jusboa/coop_door/README.md

# coop_door
Chicken coop door

Opens/closes a chicken coop door based on the daylight. Door is operated by a DC motor. Daylight is detected via a photoresistor.

Software runs on Raspberry Pico. Powered by battery.
