jusboa/coop_door/hw/coop_door.kicad_pcb

## KiCad design hw/coop_door.kicad_pcb (2025-11-10)

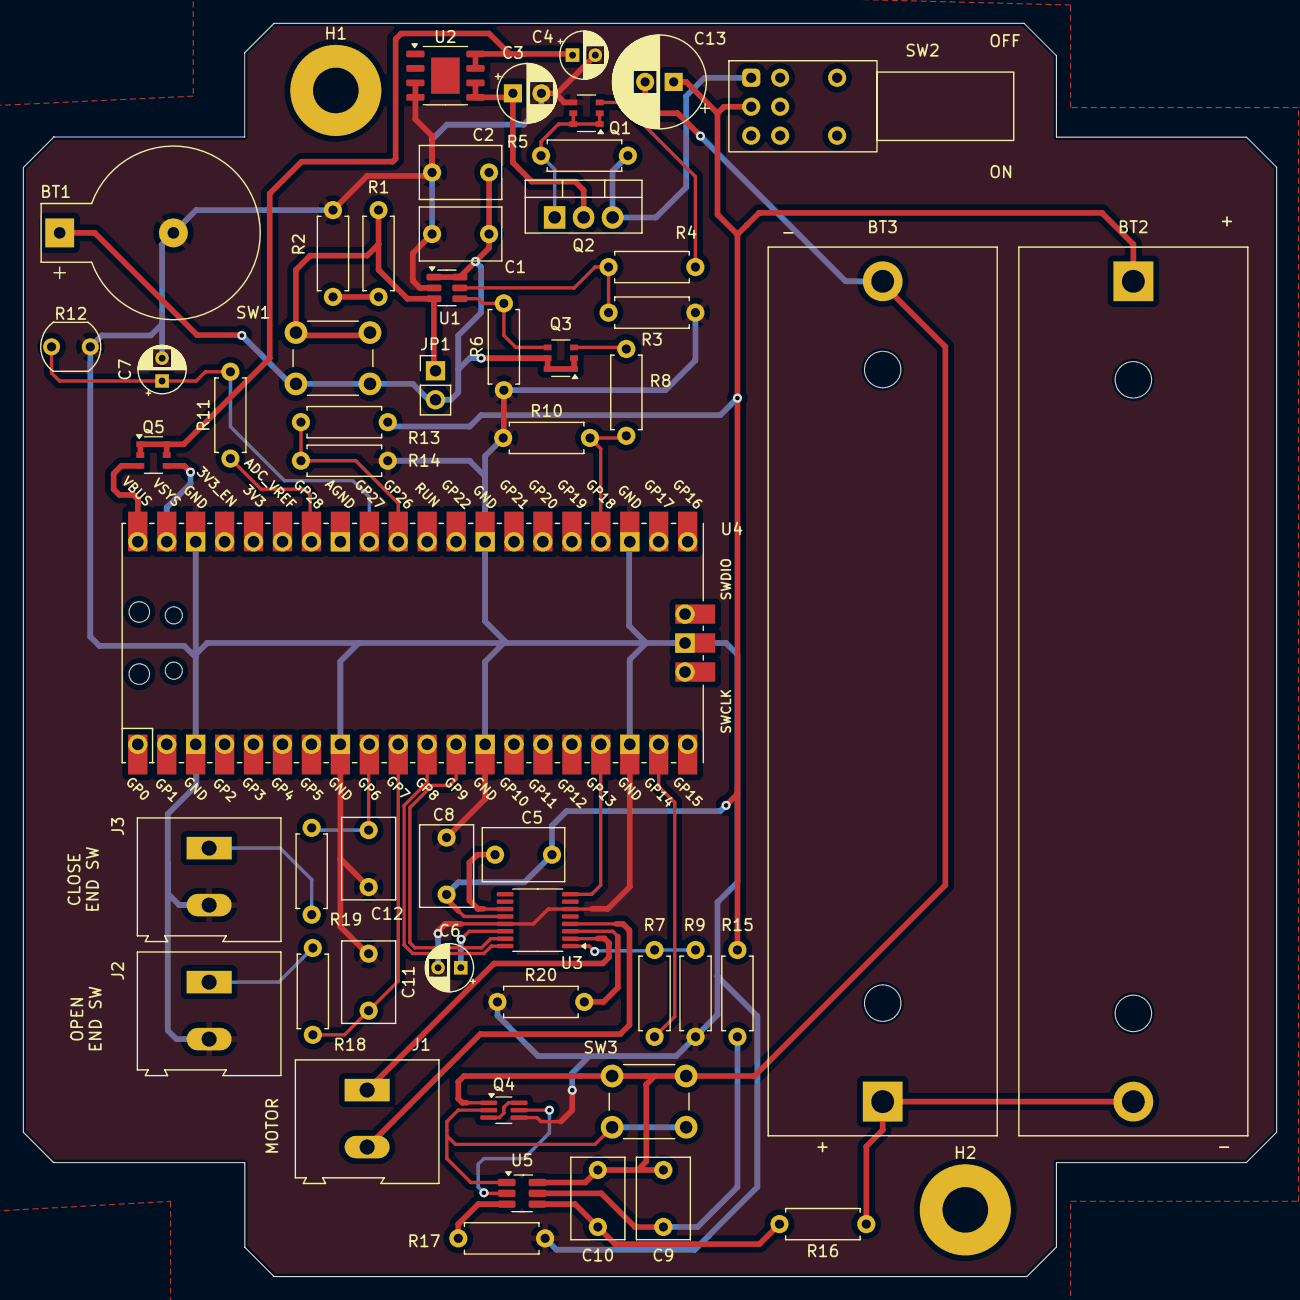
[picture p1: board coop_door.kicad_pcb from above]

Board: 2 copper layers, 110.0 x 110.0 mm, 55 parts (0 on the bottom side), 41 nets.

Parts:
BT1: CR1220; BatteryHolder_Keystone_500
BT2, BT3: Battery_Cell; BatteryHolder_MPD_BH-18650-PC2
C1, C9, C10: 0.1u; C_Rect_L7.0mm_W4.5mm_P5.00mm
C2, C8: 10u; C_Rect_L7.0mm_W4.5mm_P5.00mm
C3: 1u; CP_Radial_D5.0mm_P2.50mm
C4, C6: 2.2u; CP_Radial_D4.0mm_P2.00mm
C5: 10n; C_Rect_L7.0mm_W4.5mm_P5.00mm
C7: 4.7u; CP_Radial_D4.0mm_P2.00mm
C11, C12: 2.2u; C_Rect_L7.0mm_W4.5mm_P5.00mm
C13: 680u; CP_Radial_D8.0mm_P2.50mm
H1, H2: MountingHole; MountingHole_4mm_Pad
J1, J2, J3: Screw_Terminal_01x02; TerminalBlock_Altech_AK300-2_P5.00mm
JP1: Jumper_2_Open; PinHeader_1x02_P2.54mm_Vertical
Q1, Q3: IRLTS6342; TSOP-6_1.65x3.05mm_P0.95mm
Q2: IRF4905; TO-220-3_Vertical
Q4: BSD235NH; SOT-363_SC-70-6_Handsoldering
Q5: BSL207SPH; TSOP-6_1.65x3.05mm_P0.95mm
R1, R2: 47k; R_Axial_DIN0207_L6.3mm_D2.5mm_P7.62mm_Horizontal
R3, R6: 51k; R_Axial_DIN0207_L6.3mm_D2.5mm_P7.62mm_Horizontal
R4, R7, R8: 1k; R_Axial_DIN0207_L6.3mm_D2.5mm_P7.62mm_Horizontal
R5, R9, R10, R11: 10k; R_Axial_DIN0207_L6.3mm_D2.5mm_P7.62mm_Horizontal
R12: GL5516; R_LDR_5.1x4.3mm_P3.4mm_Vertical
R13: 15k; R_Axial_DIN0207_L6.3mm_D2.5mm_P7.62mm_Horizontal
R14, R18, R19: 5k; R_Axial_DIN0207_L6.3mm_D2.5mm_P7.62mm_Horizontal
R15, R16: 470; R_Axial_DIN0207_L6.3mm_D2.5mm_P7.62mm_Horizontal
R17: 2k; R_Axial_DIN0207_L6.3mm_D2.5mm_P7.62mm_Horizontal
R20: 0R68; R_Axial_DIN0207_L6.3mm_D2.5mm_P7.62mm_Horizontal
SW1, SW3: SW_Push; SW_PUSH_6mm
SW2: SW_DPDT_x2; Double_Toggle_Switch_8Pins_THT_H10mm_W9mm_L24mm_Vertical
U1: TPL5111; SOT-23-6
U2: TPS76633; SOIC-8-1EP_3.9x4.9mm_P1.27mm_EP2.514x3.2mm
U3: DRV8833PW; TSSOP-16_4.4x5mm_P0.65mm
U4: Pico; RPi_Pico_SMD_TH
U5: S-8252; SOT-23-6_Handsoldering

Connections:
+BATT: BT2.1 (+), C5.1, C8.2, C13.1, R13.1, R15.1, SW2.2 (B), U3.12 (VM)
/VBUS: Q5.3 (G), U4.40 (VBUS)
/VIN: C3.1, Q2.2 (D), U2.5 (IN), U2.6 (IN)
/VSYS: Q5.4 (S), U4.39 (VSYS)
/battery_sense: R13.2, R14.1, U4.31 (GPIO26_ADC0)
/close_end_switch: C12.1, R19.1, U4.9 (GPIO6)
/done: R8.1, R10.2, U4.24 (GPIO18)
/light_sense: C7.1, R11.2, R12.1, U4.32 (GPIO27_ADC1)
/light_sense_control: R11.1, U4.34 (GPIO28_ADC2)
/motor_drv_AIN1: U3.16 (AIN1), U4.11 (GPIO8)
/motor_drv_AIN2: U3.15 (AIN2), U4.12 (GPIO9)
/motor_drv_AISEN: R20.2, U3.3 (AISEN)
/motor_drv_AOUT1: J1.1, U3.2 (AOUT1)
/motor_drv_AOUT2: J1.2, U3.4 (AOUT2)
/motor_drv_nFAULT: U3.8 (nFAULT), U4.17 (GPIO13)
/motor_drv_nSLEEP: R7.2, U4.19 (GPIO14)
/open_end_switch: C11.1, R18.1, U4.10 (GPIO7)
/power_control: R3.2, R4.2, U1.5 (~DRV)
GND: BT1.2 (-), C1.2, C2.2, C3.2, C4.2, C6.2, C7.2, C8.1, C11.2, C12.2, J2.2, J3.2, Q1.4 (S), Q4.4 (S), R2.1, R3.1, R6.1, R9.2, R10.1, R12.2, R14.2, R17.2, R20.1, U1.2 (GND), U2.3 (GND), U2.4 (nEN), U3.6 (BISEN), U3.13 (GND), U4.3 (GND), U4.8 (GND), U4.13 (GND), U4.18 (GND), U4.23 (GND), U4.28 (GND), U4.38 (GND), U4.42 (GND)
unnamed: BT2.2 (-), BT3.1 (+), R16.1
unnamed: BT3.2 (-), C9.2, C10.2, C13.2, Q4.1 (S), SW3.1, U5.6 (VSS)
unnamed: J2.1, R18.2
unnamed: J3.1, R19.2
unnamed: JP1.1 (A), R1.2, SW1.1, U1.3 (DELAY/M_DRV)
unnamed: Q1.3 (G), R4.1
unnamed: Q1.1 (D), Q1.2 (D), Q1.5 (D), Q1.6 (D), Q2.1 (G), R5.2
unnamed: Q2.3 (S), R5.1, SW2.1 (A)
unnamed: Q3.3 (G), R8.2
unnamed: Q3.4 (S), R6.2, U1.4 (DONE)
unnamed: Q4.3 (D), Q4.6 (D)
unnamed: Q4.2 (G), SW3.2, U5.1 (DO)
unnamed: Q4.5 (G), U5.2 (CO)
unnamed: R1.1, R2.2
unnamed: C5.2, U3.11 (VCP)
unnamed: C6.1, U3.14 (VINT)
unnamed: R7.1, R9.1, U3.1 (nSLEEP)
unnamed: C10.1, R16.2, U5.4 (VC)
unnamed: C9.1, R15.2, U5.5 (VDD)
unnamed: R17.1, U5.3 (VM)
VCC: C4.1, Q5.1 (D), Q5.2 (D), Q5.5 (D), Q5.6 (D), U2.7 (OUT), U2.8 (OUT)
VDD: BT1.1 (+), C1.1, C2.1, JP1.2 (B), Q3.1 (D), Q3.2 (D), Q3.5 (D), Q3.6 (D), SW1.2, U1.1 (VDD), U1.6 (EN/ONE_SHOT)
