jusboa/coop_door/(commit log)

2023-11-20 Adding first draft for dcmotor drive, end_switch drive, light sensor and task scheduler
2023-11-23 Adding more motor tests.
2024-08-27 Adding a digital filter
2024-10-18 * More business logic * Use callback to get state of switches and day/night
2024-10-19 Test observer slots.
2024-10-23 Add light sensor tests.
2024-12-09 Timer needs to be started on a state entry,
    simplify hierarchy dealing.
2024-12-14 Add timer test
    Update light sensor resistances to match actual values.
    Update GPIO pins and ADC channel to match actual schematics.
2024-12-14 Fix wrong import in timer.
    Fix timer callback, it needs to take a timer object as its argument.
    [timer.py, timer_test.py]
2024-12-14 Update tests to match the timer callback.
2024-12-14 Read light periodically.
    Test the HW wiring (pins and ADC channel).
2024-12-15 Periodically refresh end switches.
    State machine needs to use single shot timer for state timeout.
    Disable logging since it is not in micropython libs.
2024-12-15 Stop the timer on exit.
    When day comes while closing the door, open it. When night comes while opening the door, close it.
2024-12-23 Power saving #1
    Disable motor driver when idled.
    Disable light sensor when idled.
    Determin only bistate of light sensor -> day/night to avoid erroneous light scaling.
    [dcmotor_drive.py, dcmotor_drive_test.py, door_controller.py, door_controller_test.py, light_sensor.py, light_sensor_test.py]
2025-01-16 Update light sensor HW
    Update pin - control pin is GPIO0.
    Update resistance to match new light sensor circuit. Rup = 10e3, sensor = GL5516.
2025-01-26 End switch revised
    * Remap end switches pins
    * Use interrupt to detect end switch state
2025-02-03 Take out switches out of periodic refresh
    * No need to ask periodically what the switches state is. They trigger external gpio interrupt on change.
    * Give signals a name
    * Use choice to decide on switch state on power up
2025-02-07 Make motor direction a parameter
2025-02-07 Separate state machines
    Separate motor control from high level business logic.
2025-02-09 reverse motor rotation
    * On stuck start switch reverse the motor direction
    * efactor tests to exploit fixtures more
    [door_controller.py, door_controller_test.py, state_machine_test.py]
2025-02-13 New HW update
    * Pin remapping
    * door controller needs to be started
    * Fix wrong switch mapping
    * Extend door drive timeouts
    * Detect both switch events - open and close
    * Fix trials limit
    [dcmotor_drive.py, door_controller.py, door_controller_test.py, end_switch.py, state_machine.py]
2025-02-22 Improve light sensor robustness
    * Add cap to filter signal - add seonsor startup delay to let the cap charge.
    * Increase light sensor hysteresis.
    * Refresh inputs less often - just once per 100ms is enough.
2025-02-22 Toggle sleep pin0
    Generate a 500Hz/50% PWM on sleep pin when going to sleep for the TPL5110 not to miss it. Sometimes it did not catch it and then it remained awaik until next cycle.
2025-02-23 Add battery voltage reading
2025-02-28 Duty cycle the motor
    * Drive the motor with PWM based on input voltage.
    * ADC fixed. It actually need to be either initialized with pin object or the corresponding pin needs to be set as input
    otherwise it's wrongly configured and gives wrong reading!
    [battery_voltage_sensor.py, battery_voltage_sensor_test.py, dcmotor_drive.py, dcmotor_drive_test.py, door_controller.py, door_controller_test.py, light_sensor.py, light_sensor_test.py]
2025-02-28 Tune day/night threshold
    Aftre the ADC pin configuration fix the day threshold had to be retuned.
    [light_sensor.py, light_sensor_test.py]
2025-03-01 Fine tune the motor drive
    * The best frequency seems to be 10 kHz. It filters well the dc component. It does not give any noise.
    * Power supply voltage is actually a bit less than 3.3 V -> typically 3.2 V.
    * Modify the battery sensing voltage divider to be able to measure up to 12V, when motor shall not be driven.
    [battery_voltage_sensor.py, battery_voltage_sensor_test.py, dcmotor_drive.py, dcmotor_drive_test.py, door_controller.py]
2025-03-02 Revise tests
    * Fixing tests that reacted on motor detach state rather than the go state.
    * Associate door drive timeout with go state.
    [door_controller.py, door_controller_test.py]
2025-04-02 install script + freq
    Add installation script.
    Lower the CPU frequency to save power.
2025-04-07 freq up, global logging settings
    Increase the clock rate since somehow the usb console does not work reliably.
    Setup logging globally in main.py.
    [door_controller.py]
2025-04-09 log to console & file
    Add file logging.
    Change log formatter to show time from the start.
    f->18MHz, the USB connection problem is most likely not due to clock freq.
    [door_controller.py]
2025-04-10 Update motor driver sleep
    Update the drv8833 sleep gpio.
    f back to 48MHz. It really is due to low clock frequency that the USB connection is not reliable.
2025-04-16 lightsleep
    Investigated lightsleep option while motor runs. But no, timers stop to do PWM.
    Got rid of some too frequent debug messages that overwhelmed the log.
2025-06-30 Add HW
    * Schematics
    * PCB
    * Project footprints
    [coop_door.kicad_pcb, coop_door.kicad_sch]
2025-07-24 Revise PCB dimensions
    * Add project specific symbol library
    * Change PCB dimensions to fit the housing
    * Move some components for the connectors to be easily accessible
    [coop_door.kicad_pcb, coop_door.kicad_sch]
2025-08-14 V-regulator
    Use a correct symbol and package for TPS76633 voltage regulator.
    [coop_door.kicad_pcb, coop_door.kicad_sch]
2025-08-18 Transitor types
    Show transitor types in the schematics
    [coop_door.kicad_sch]
2025-08-25 Battery terminals
    Adding labels +/- to battery holders.
    [coop_door.kicad_pcb]
2025-08-26 PCB fixes
    - Fix the battery protection IC MOSFET connections
    - Add the main switch ON/OFF silkscreen labels
    [coop_door.kicad_pcb, coop_door.kicad_sch]
2025-08-26 Termials labels
    Add labels to end switch and motor terminals.
    [coop_door.kicad_pcb]
2025-08-26 Update venv
    - Update venv packages
    - Fix some wrong test assertions
    [door_controller_test.py, state_machine_test.py]
2025-08-26 Update pinout
    Update pinout to the new PCB
2025-08-28 Fix C13
    Fix the schematics - C13 needs to be connected accross the battery, otherwise U5 detects voltage drop when motor starts and shuts the device down.
    [coop_door.kicad_sch]
2025-11-10 Update schematics&PCB
    - Add button to start the battery protection IC
    - Add motor resitor to AISEN pin to limit the current to ~300mA
    [coop_door.kicad_pcb, coop_door.kicad_sch]
